johnsonm/Replicase/replicase.stl

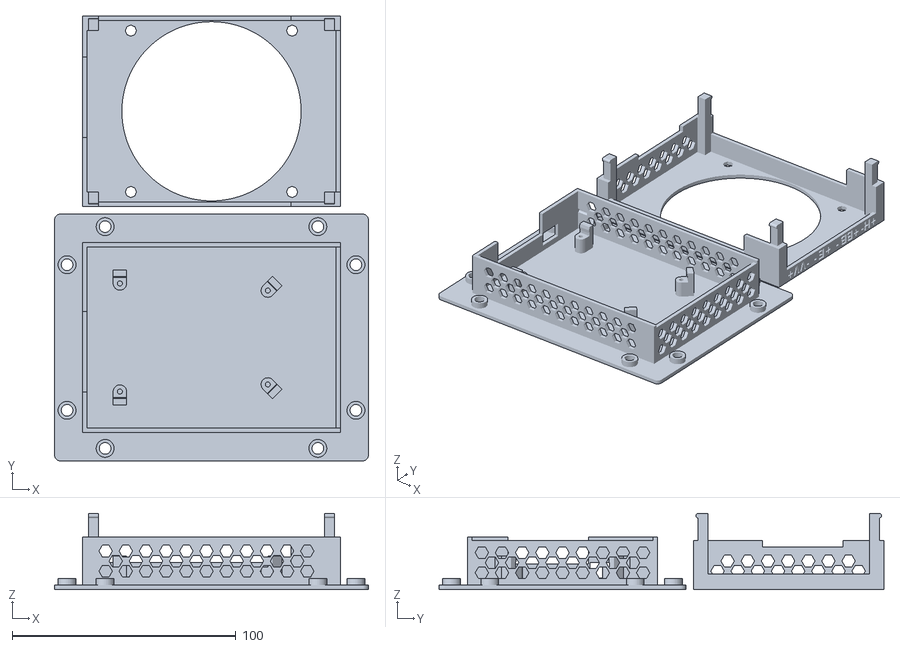
[picture p1: CAD file, 2018-03-17]
replicase.stl
140.2 x 198.6 x 34.0
