johnsonm/Replicase/(commit log)

2018-03-10 Initial design
    This design has not been test-printed; it is conceptual and based
    on somewhat imprecise measurements.
    [replicase.scad, replicase.stl]
2018-03-10 Add more ventilation
    [replicase.scad, replicase.stl]
2018-03-10 Add labels to side of case top
    [replicase.scad, replicase.stl]
2018-03-10 Add power labels to end of case top
    [replicase.scad, replicase.stl]
2018-03-10 Increase top clip length to engage base
    [replicase.scad, replicase.stl]
2018-03-10 First print
2018-03-10 Extend flange to full intended size on sides further from origin
    [replicase.scad, replicase.stl]
2018-03-11 Improve fit from first print
    Move the standoffs one shell further in X; the previous measurements
    did not account for the thickness of the shell. Make the clips on
    the standoffs much smaller with gentler slope; they were too thick
    and and prevented the board from fitting without cutting away.
    Lots of small modifications around Ethernet and USB ports to fit
    with more variations. The reduction in pcb board thickness is
    part of this.
    Change all fonts to bold as the horizontal parts mostly disappeared
    in the layers. Adjust some off the offsets to more clearly label
    the stepper motor connectors.
    Two of the top/bottom case clips broke on initial assembly, so make
    the engagement between the cas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
    [replicase.scad, replicase.stl]
2018-03-12 Improve fit from second print
    The bottom of the molex connector is lower than the top of the
    ethernet jack, so increase the size of the lower case half and
    cut away a slot for the molex connector. The mini/micro USB
    slot did not reach quite high enough to be useful, so move it
    up to make it more likely to work.
    Change the clip structure to a tab and relief instead of interlocking
    tabs, and make the clip thicker and stronger. Clips still broke
    on the second iteration.
    The example gcode file is sliced with .15mm layers as this seems
    to produce better results for labels on top half. Switched from
    3 to 5 top and bottom solid layers to accomodate this change.
    [replicase.scad, replicase.stl]
2018-03-13 Update README; put interesting parameters first
    More useful information added to README, and put the parameters
    intended for modification first in the model.
    [replicase.scad]
2018-03-13 Improve fit from third print
    Center the board properly instead of trying to use measured offsets.
    Accomodate the BB ethernet and Replicape inductor height with a
    cutout from the case top instead of increasing the bottom height,
    because increasing the bottom height interfered with all the side
    connectors.
    Reduce board standoff clip size further; 1mm worked for PETG but
    is too much for PLA+, so try 0.5mm.
    Add some slop for interference fit for top clips; make the relief
    larger and cut away the edge of the tab to make it easier to insert
    the clips into the case. Use mirror() to distribute the clips.
    (Should probably use mirror() a lot more in the whole design!)
    Change the power labels; the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
    [replicase.scad, replicase.stl]
2018-03-13 Fix off-center mounting from fourth print
    The previous print inadvertently moved the BB out of center instead
    of closer to center. Fix that.
    Change the labels for the power connectors to be oriented vertically
    like the other labels, and simplify to use one character for power
    connections that are not redundant.
    Change the fan hole to use more segments to make it smoother.
    Update the README with instructions for installing the BB.
    [replicase.scad, replicase.stl]
2018-03-14 Fix label mistake from fifth print
    The heated bed and second extruder heater labels had the wrong
    number of letters, so fixed them to follow the pattern that the
    doubled connectors have doubled letters.
    Made the clips even thicker to make them stronger, since I broke
    one clip again when assembling the fifth print. Made them as
    thick as they can reasonably be in the Y axis by matching the
    cutout for the molex connector. To strengthen them more would
    require a change in design.
    No change to the bottom box, only the top.
    [replicase.scad, replicase.stl]
2018-03-17 Fix wrong X1 end stop label
    [replicase.scad, replicase.stl]
